mavxg/kitchen/Assemblies/GasMeterBoxing.FCStd

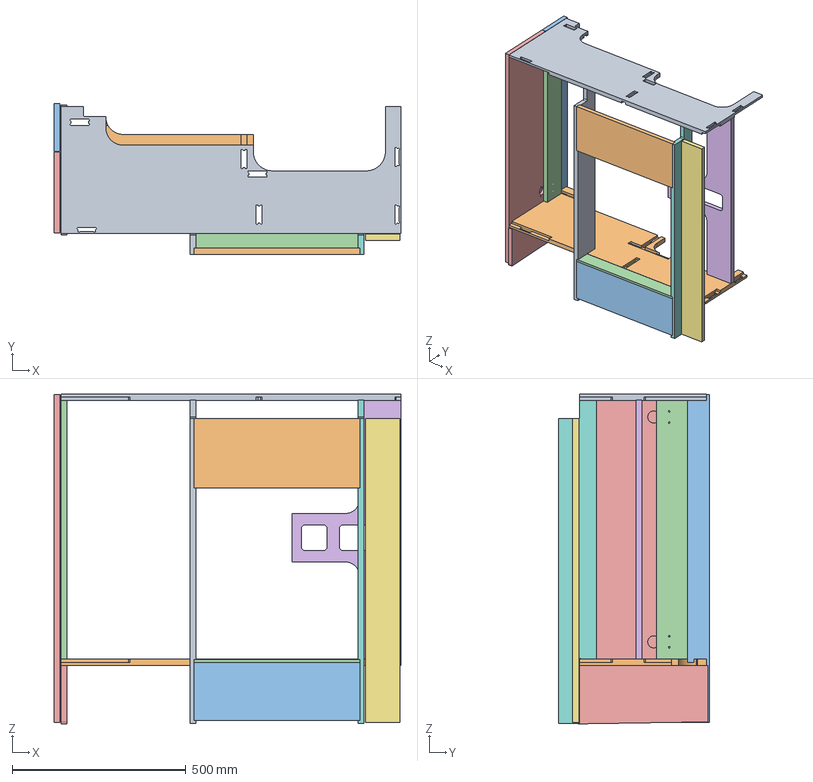
[picture p1: CAD file, 2022-05-16]
Assemblies/GasMeterBoxing.FCStd
1000.0 x 435.0 x 950.5 mm
Top012
Bottom014
Scriber
HingeUpright
Door
SocketMountUpright
Front
WorktopSupportUpright
WorktopSupportUpright002
TopSupportStretcher
BottomSupportStretcher
BottomSupportCross
Kickplate
