mavxg/kitchen/Assemblies/Cabinet011.FCStd

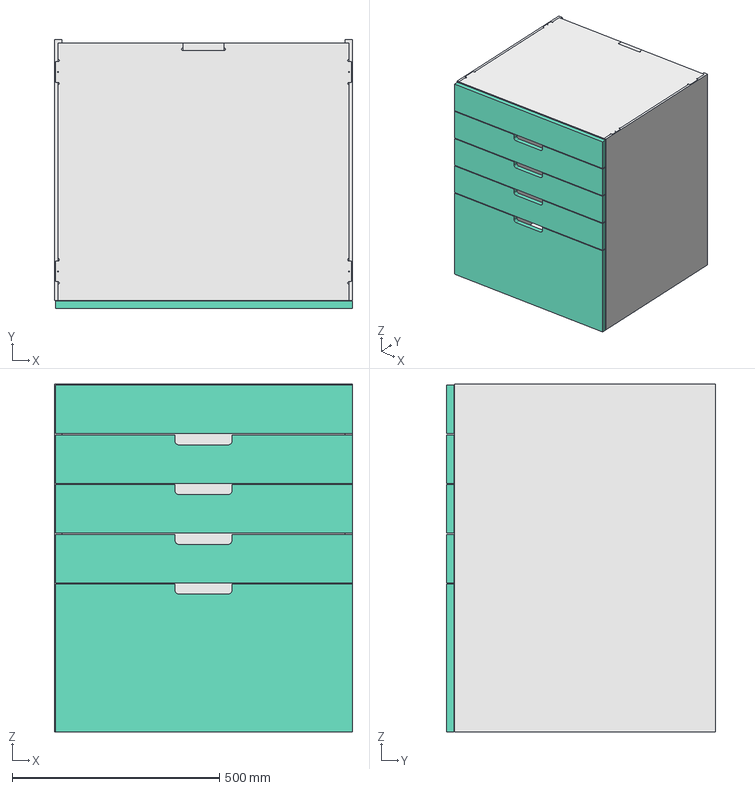
[picture p2: CAD file, 2022-05-16]
Assemblies/Cabinet011.FCStd
720.0 x 650.0 x 840.0 mm
Top
Bottom
Left
Right
BackPanel
Front001
Front002 x 3
Front005
