mavxg/kitchen/Components/QuookerPro3.FCStd

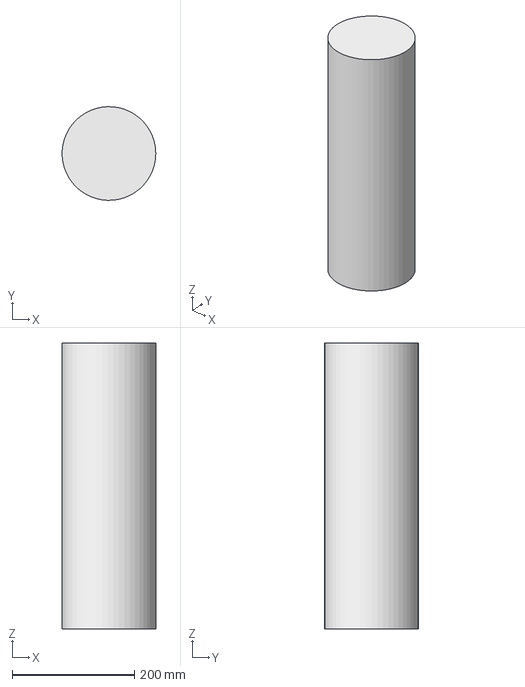
[picture p3: CAD file, 2022-05-16]
Components/QuookerPro3.FCStd
152.9 x 152.9 x 467.0 mm
