mavxg/kitchen/Kitchen.FCStd

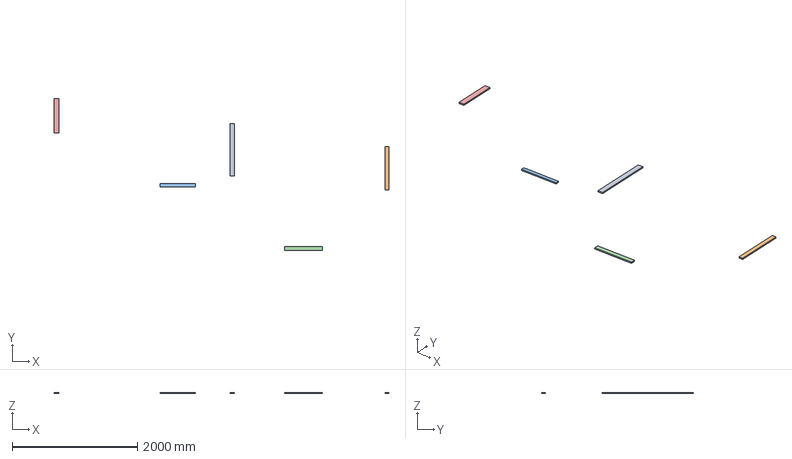
[picture p4: CAD file, 2022-05-16]
Kitchen.FCStd
5344.0 x 2419.0 x 18.0 mm
BattonForDrawerUnit
BattonForDrawerUnit001
BlackOutBatton
KickplateBathroom
CU_Batton
