mavxg/kitchen/Assemblies/Leveling.FCStd

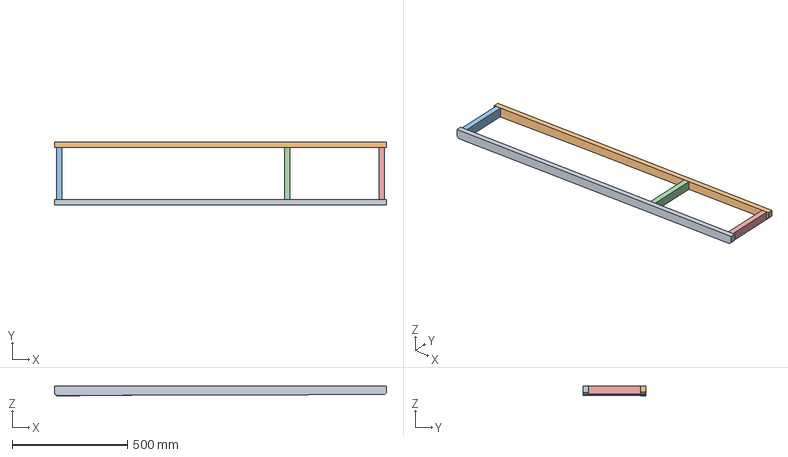
[picture p5: CAD file, 2022-05-16]
Assemblies/Leveling.FCStd
1438.0 x 274.0 x 42.9 mm
Front
Back
Stretcher
Stretcher001
Stretcher002
