mavxg/kitchen/Components/Radiator1.FCStd

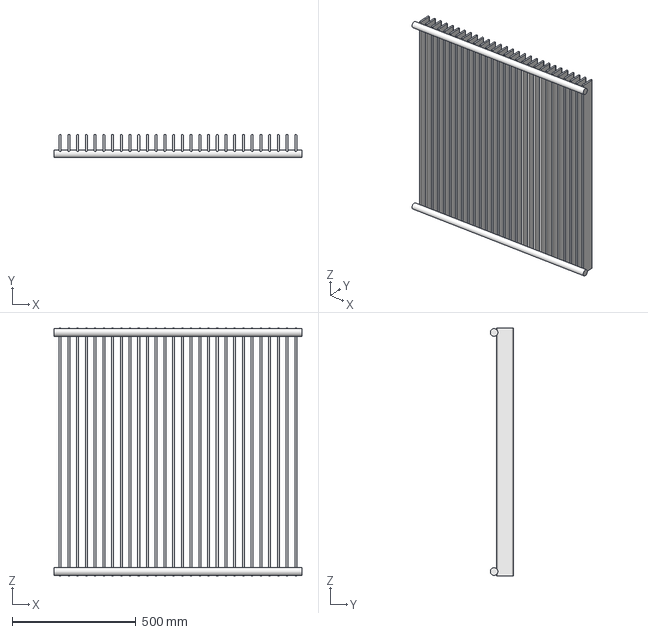
[picture p6: CAD file, 2022-05-16]
Components/Radiator1.FCStd
1000.0 x 94.7 x 1000.0 mm
