mavxg/kitchen/House.FCStd

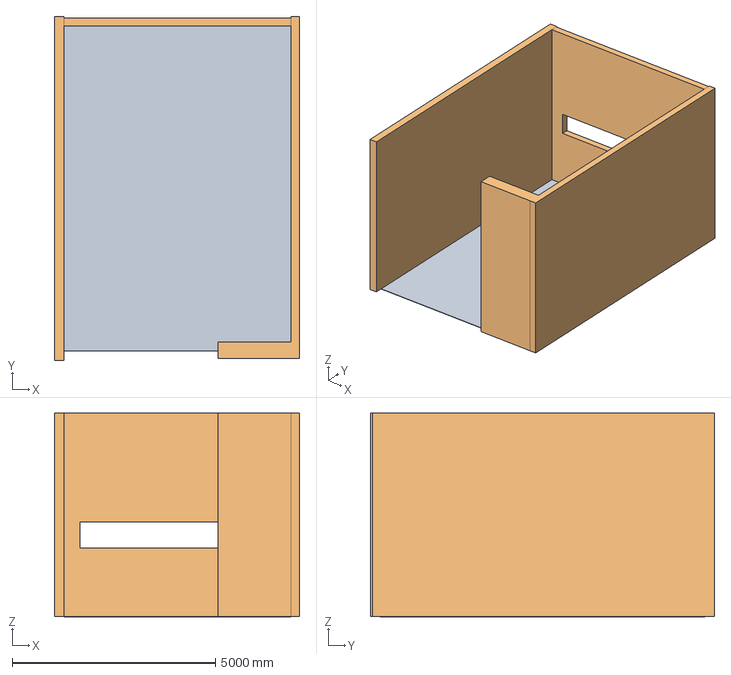
[picture p7: CAD file, 2022-05-16]
House.FCStd
6027.0 x 8464.5 x 5010.0 mm
Floor
Walls
