mavxg/kitchen/Assemblies/Cabinet012.FCStd

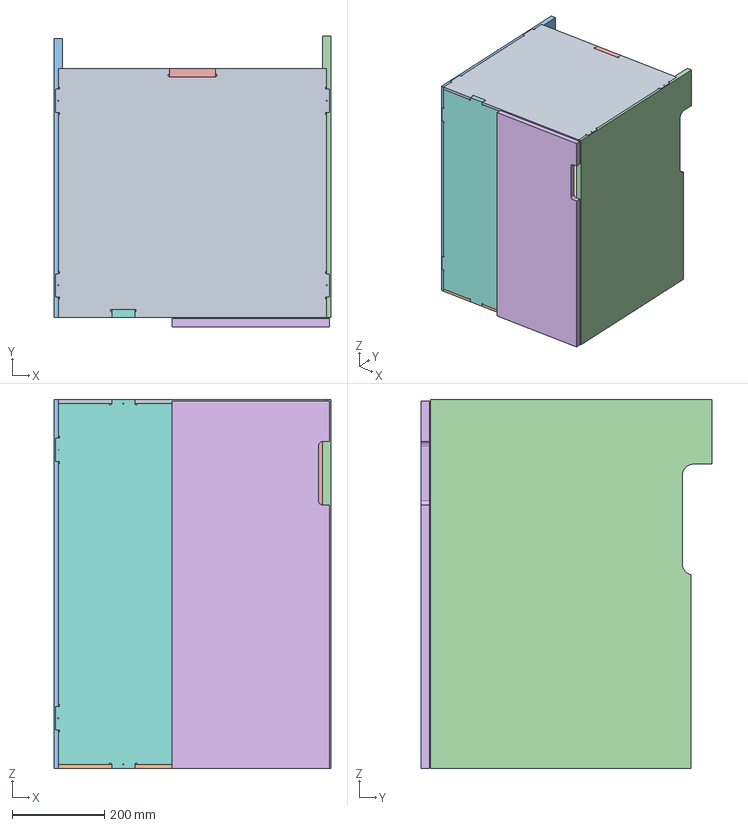
[picture p8: CAD file, 2022-05-16]
Assemblies/Cabinet012.FCStd
600.0 x 630.0 x 800.0 mm
Top
Bottom
Left
Right
BackPanel
LeftDoor
Shelf
FrontPanel
