mavxg/kitchen/Components/FrankeMythos210-45.FCStd

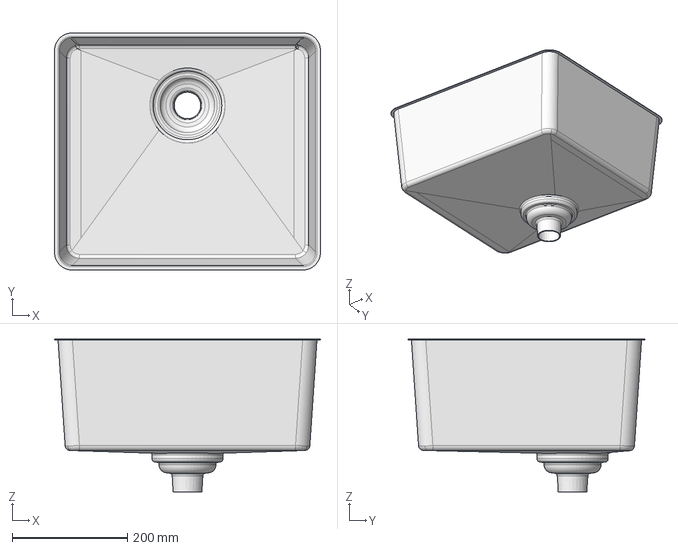
[picture p9: CAD file, 2022-05-16]
Components/FrankeMythos210-45.FCStd
462.0 x 412.0 x 265.0 mm
