mavxg/kitchen/Assemblies/Cabinet007.FCStd

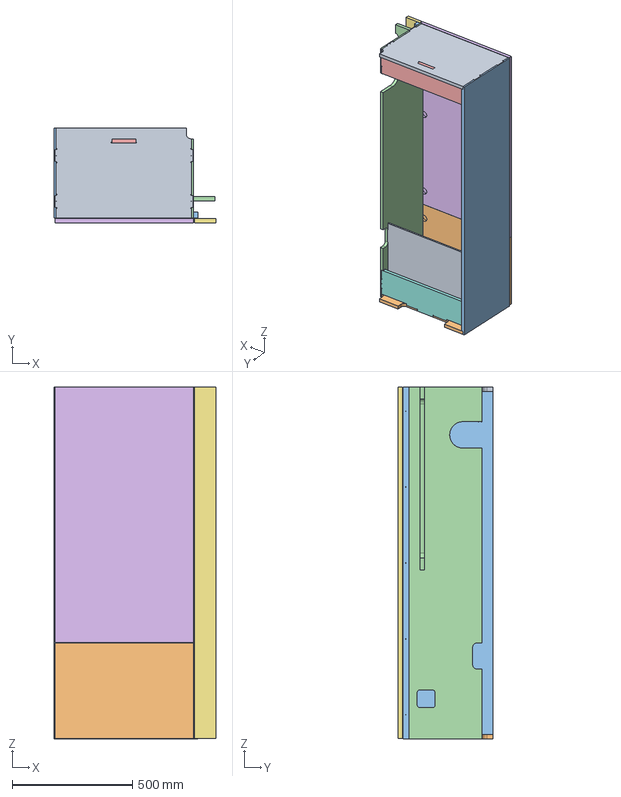
[picture p10: CAD file, 2022-05-16]
Assemblies/Cabinet007.FCStd
673.0 x 395.0 x 1463.0 mm
Top
Bottom
Left
Right
BackPanel
RightDoor
Scriber
BackPanel001
Back
RightDoor001
Batton
Bracing
