mavxg/kitchen/Components/Dline90Crank.FCStd

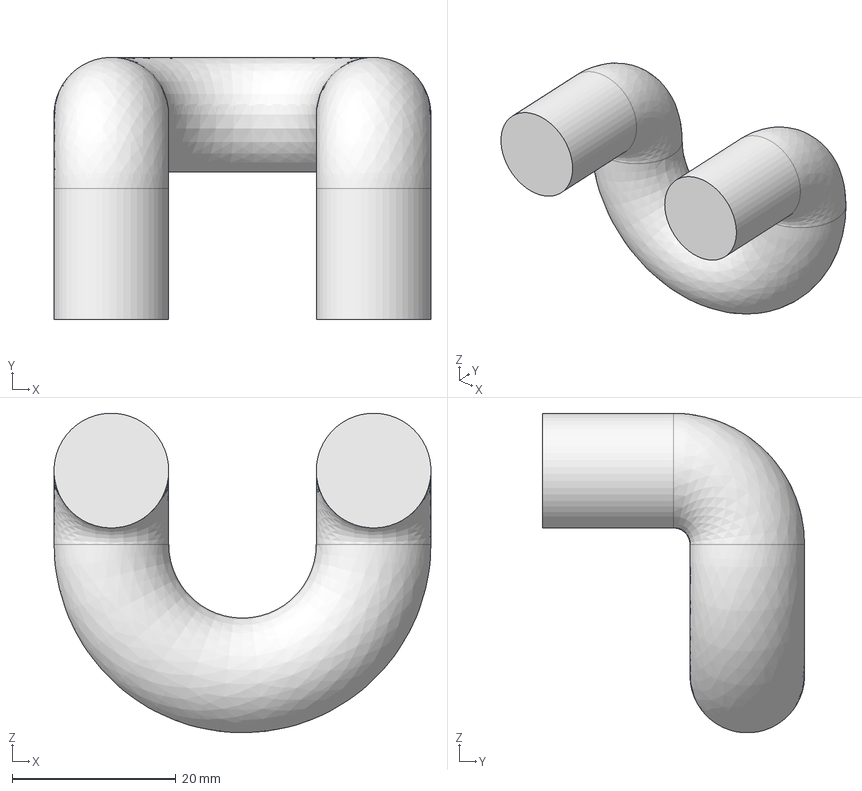
[picture p11: CAD file, 2022-05-16]
Components/Dline90Crank.FCStd
46.0 x 32.0 x 39.0 mm
