mavxg/kitchen/Assemblies/DrawerBox003.FCStd

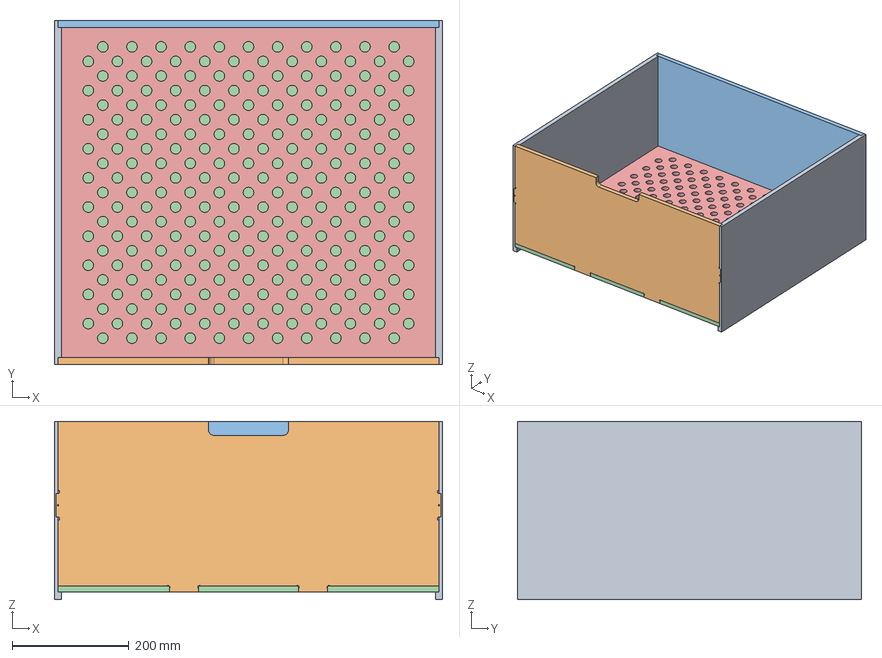
[picture p12: CAD file, 2022-05-16]
Assemblies/DrawerBox003.FCStd
666.0 x 590.0 x 306.0 mm
Left x 2
Front
Rear
Bottom
Inlay
