mavxg/kitchen/Components/Radiator2.FCStd

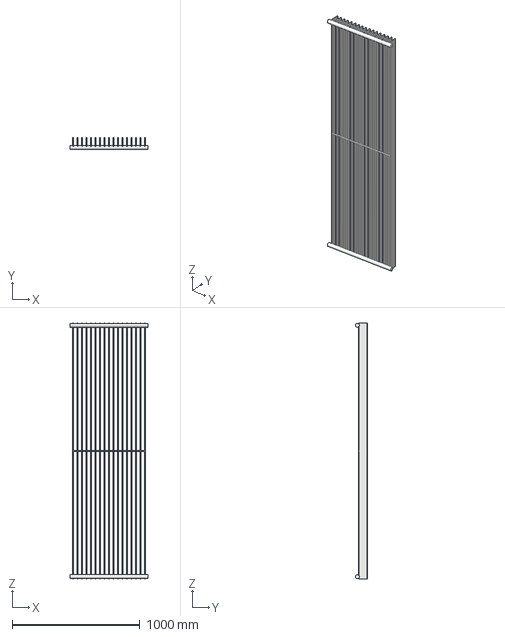
[picture p13: CAD file, 2022-05-16]
Components/Radiator2.FCStd
610.0 x 94.7 x 2000.0 mm
