mavxg/kitchen/Assemblies/DrawerBox002.FCStd

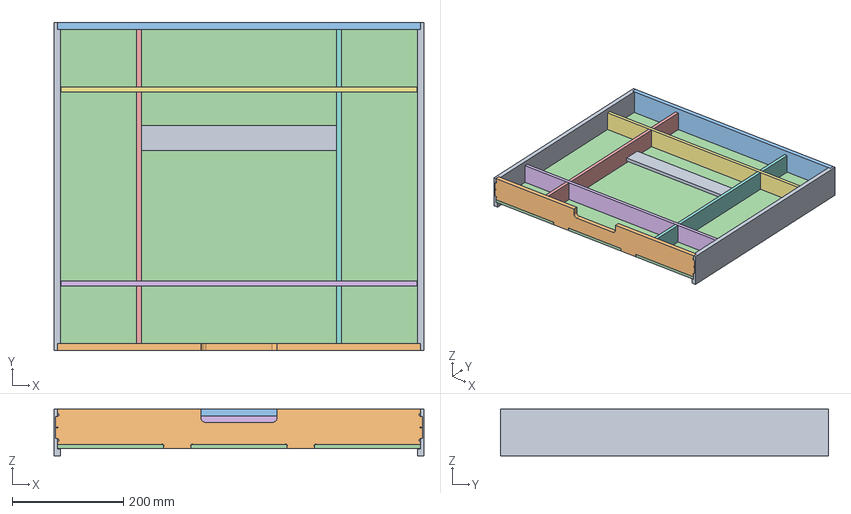
[picture p14: CAD file, 2022-05-16]
Assemblies/DrawerBox002.FCStd
666.0 x 590.0 x 84.0 mm
Left x 2
Front
Rear
Bottom
LongCrossDivider x 2
Divider001 x 2
Divider x 2
LongCrossDivider002 x 2
KnifeMagnetBlock x 2
