mavxg/kitchen/Components/BlancoOrga60_2.FCStd

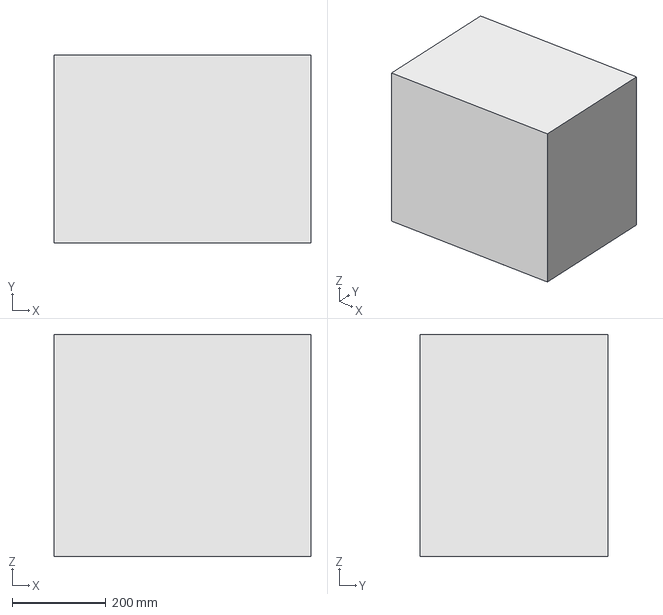
[picture p15: CAD file, 2022-05-16]
Components/BlancoOrga60_2.FCStd
547.0 x 400.0 x 473.0 mm
