mavxg/kitchen/Assemblies/IslandLeveling.FCStd

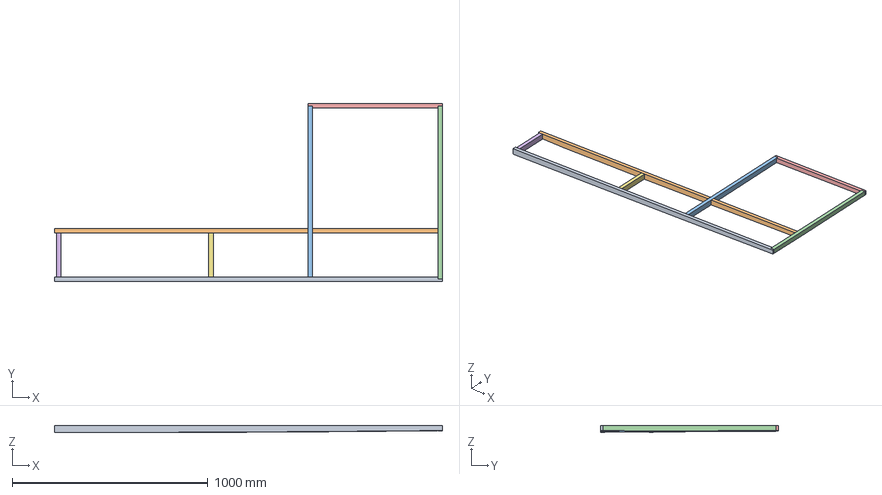
[picture p16: CAD file, 2022-05-16]
Assemblies/IslandLeveling.FCStd
1984.0 x 910.0 x 38.0 mm
Longways
Longways001
Crossways
Crossways001
Longways002
Stretcher
Stretcher001
