mavxg/kitchen/Components/QuookerFusionRound.FCStd

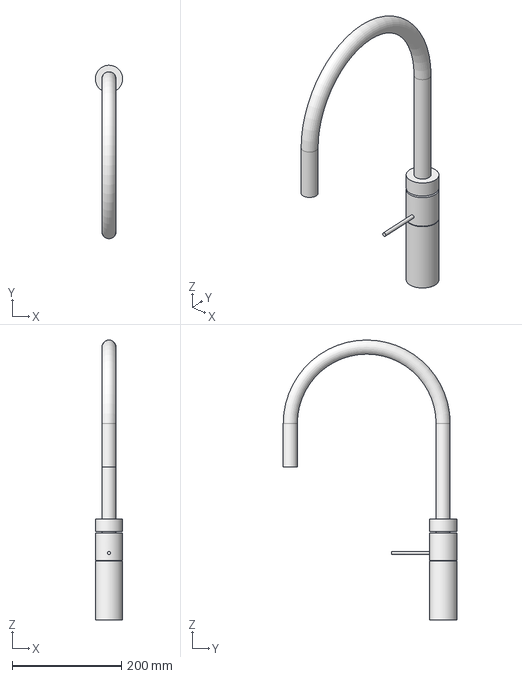
[picture p17: CAD file, 2022-05-16]
Components/QuookerFusionRound.FCStd
50.0 x 318.0 x 513.0 mm
