mavxg/kitchen/Assemblies/Cabinet009.FCStd

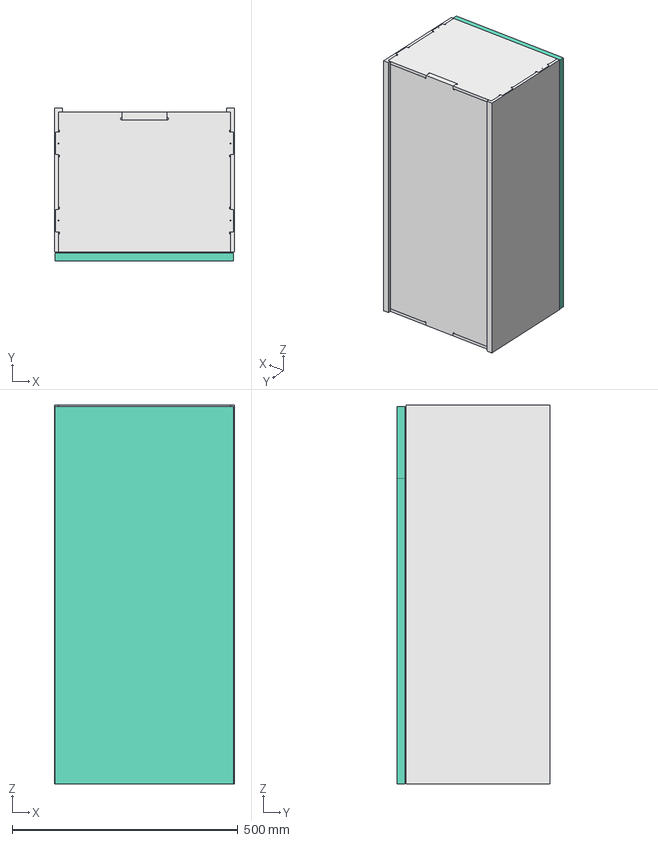
[picture p18: CAD file, 2022-05-16]
Assemblies/Cabinet009.FCStd
400.0 x 340.0 x 840.0 mm
Top
Bottom
Left
Right
BackPanel
LeftDoor
Shelf
