mavxg/kitchen/Components/DlineHandle.FCStd

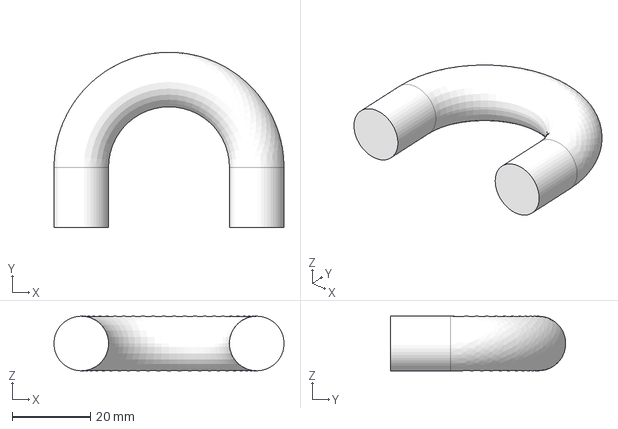
[picture p19: CAD file, 2022-05-01]
Components/DlineHandle.FCStd
59.0 x 45.0 x 14.0 mm
