mavxg/kitchen/Assemblies/Footing.FCStd

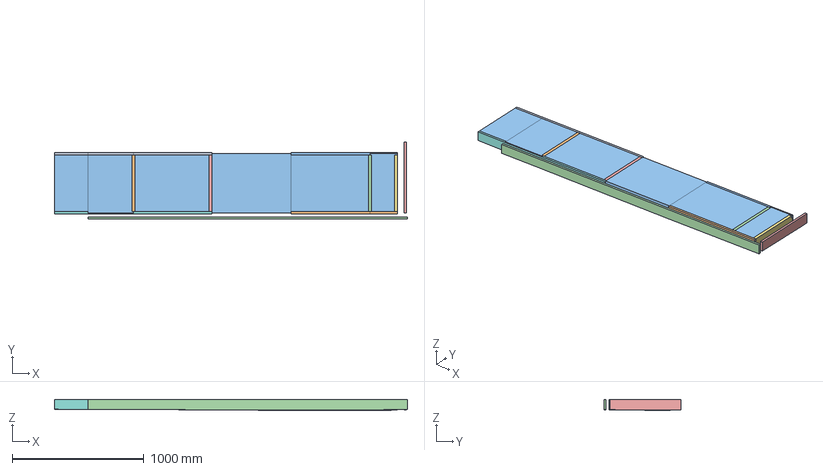
[picture p20: CAD file, 2022-05-16]
Assemblies/Footing.FCStd
2683.0 x 588.0 x 81.9 mm
Cross
Cross001
Skeleton
Cross004
Cross002
Cross003
Cross005
LeftFront
LeftRear
RightFront
RightRear
Kickplate
EndKickplate
