mavxg/kitchen/Components/Blum.FCStd

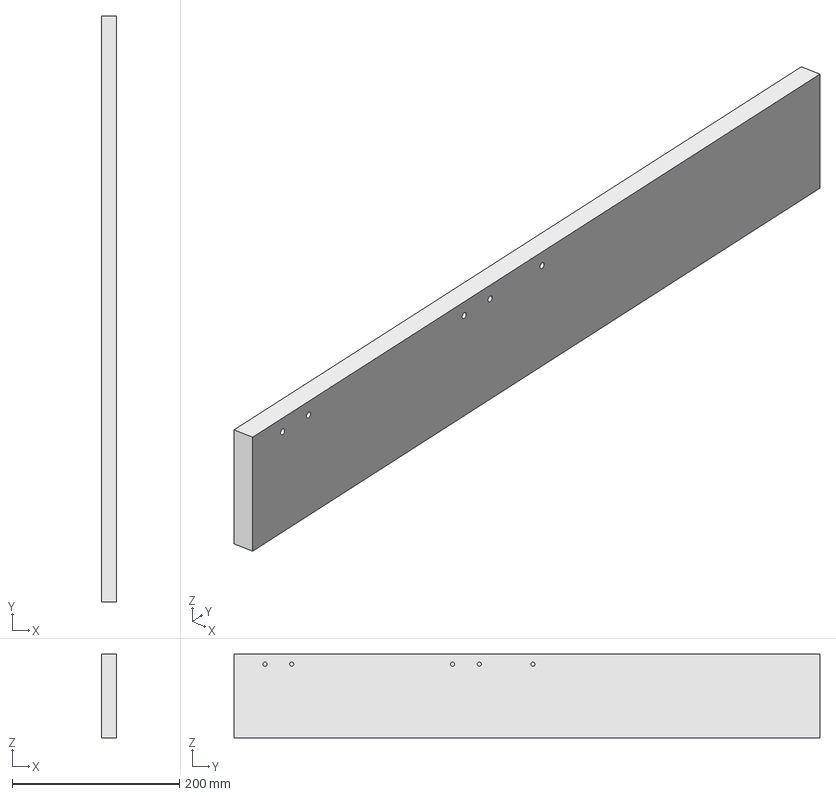
[picture p21: CAD file, 2022-05-01]
Components/Blum.FCStd
18.0 x 700.0 x 100.0 mm
