mavxg/kitchen/Assemblies/Cabinet001.FCStd

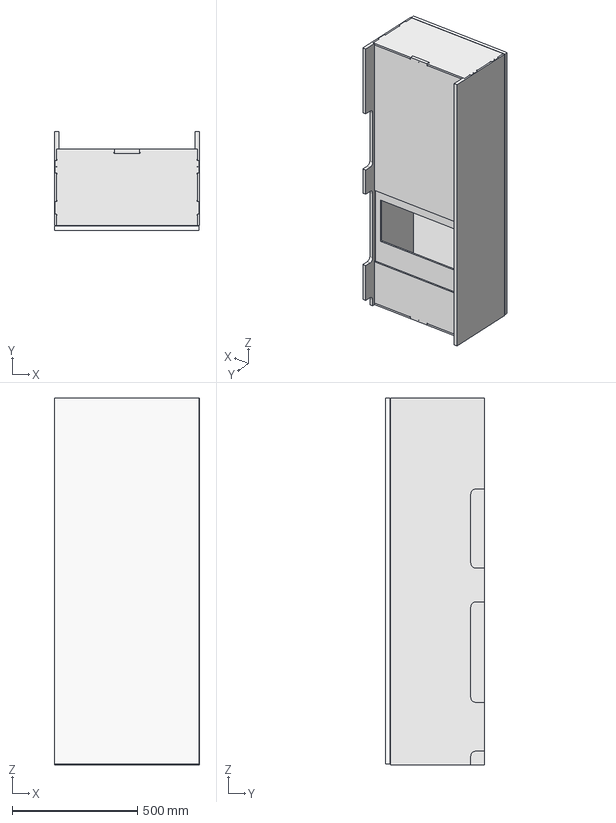
[picture p22: CAD file, 2022-05-16]
Assemblies/Cabinet001.FCStd
580.0 x 395.0 x 1463.0 mm
Top
Bottom
Left
Right
BackPanelBottom
RightDoor
Shelf
BackPanelTop
RemovableBack
