mavxg/kitchen/Components/Radiator3.FCStd

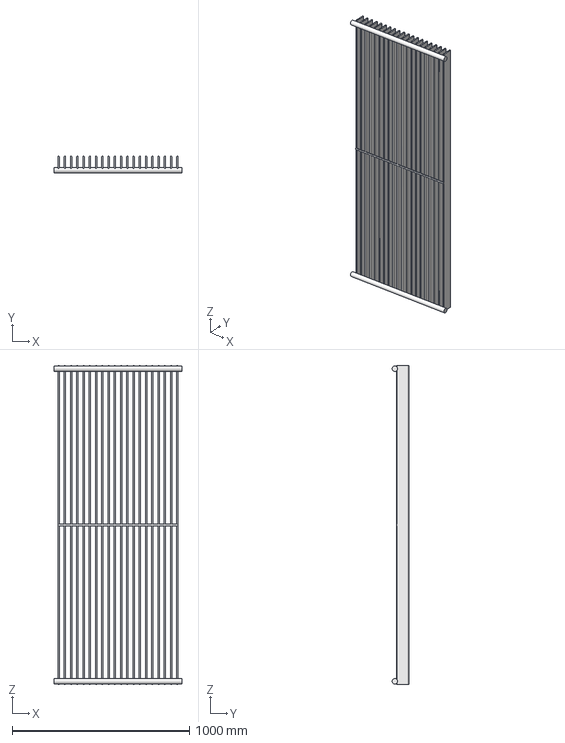
[picture p23: CAD file, 2022-05-01]
Components/Radiator3.FCStd
720.0 x 94.7 x 1800.0 mm
