mavxg/kitchen/Assemblies/Cabinet015.FCStd

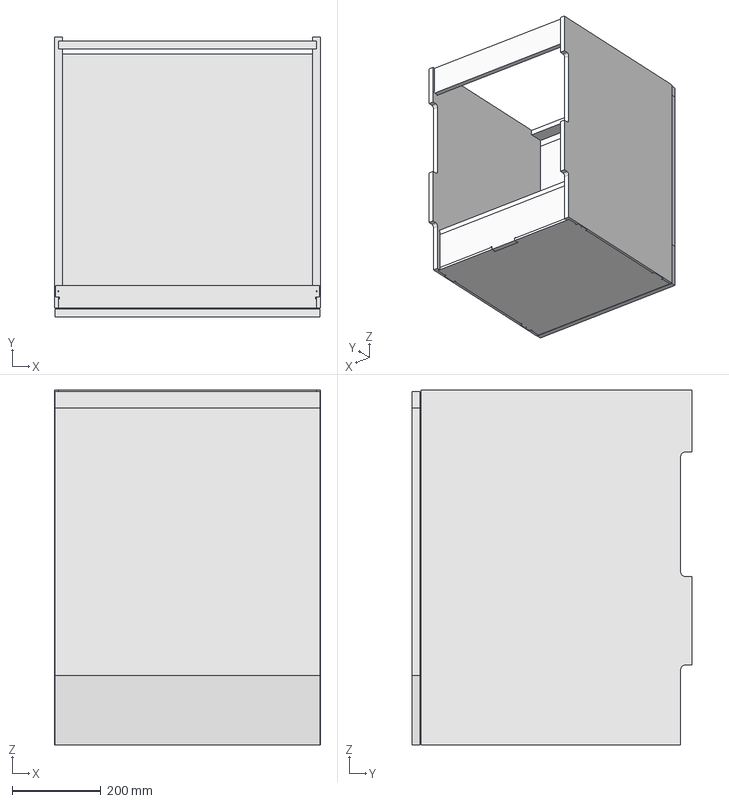
[picture p24: CAD file, 2022-05-16]
Assemblies/Cabinet015.FCStd
600.0 x 630.0 x 800.0 mm
TopStretcher
Bottom
Left
Right
BackPanel
LeftDoor
Shelf
FrontPanel001
FrontPanel002
BackStretcher002
