mavxg/kitchen/Components/PullHandle.FCStd

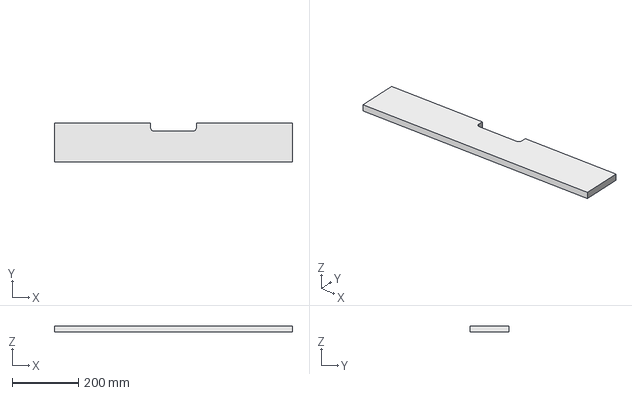
[picture p25: CAD file, 2022-04-24]
Components/PullHandle.FCStd
717.0 x 117.0 x 18.0 mm
