mavxg/kitchen/Assemblies/DrawerBoxEnd003.FCStd

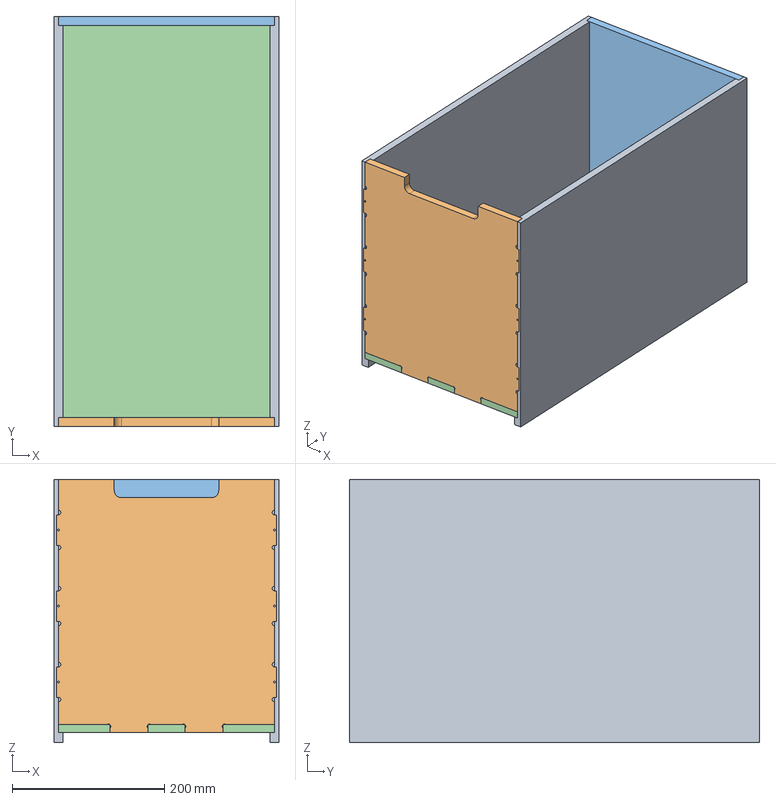
[picture p26: CAD file, 2022-05-16]
Assemblies/DrawerBoxEnd003.FCStd
296.0 x 540.0 x 346.0 mm
Left x 2
Front
Rear
Bottom
