mavxg/kitchen/Components/DrawerBox.FCStd

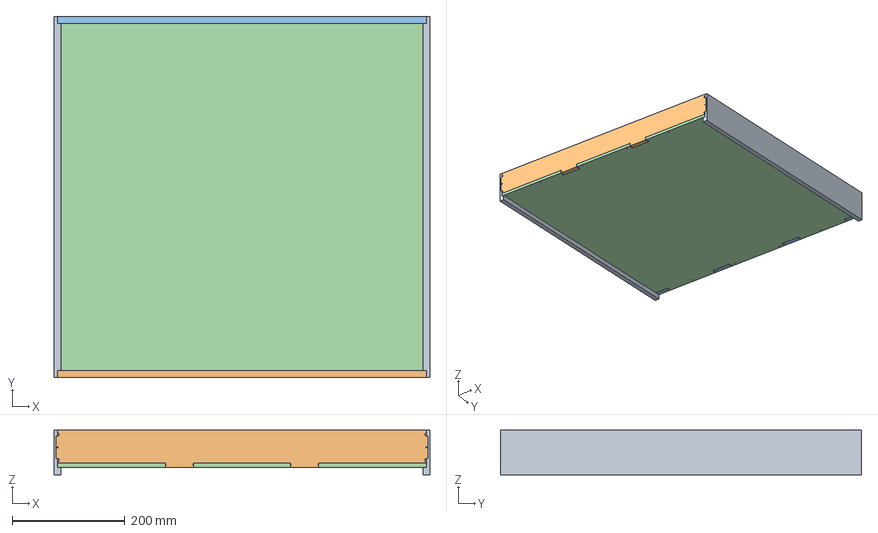
[picture p27: CAD file, 2022-04-24]
Components/DrawerBox.FCStd
666.0 x 640.0 x 79.0 mm
Left x 2
Front
Rear
Bottom
