mavxg/kitchen/Assemblies/Cabinet003.FCStd

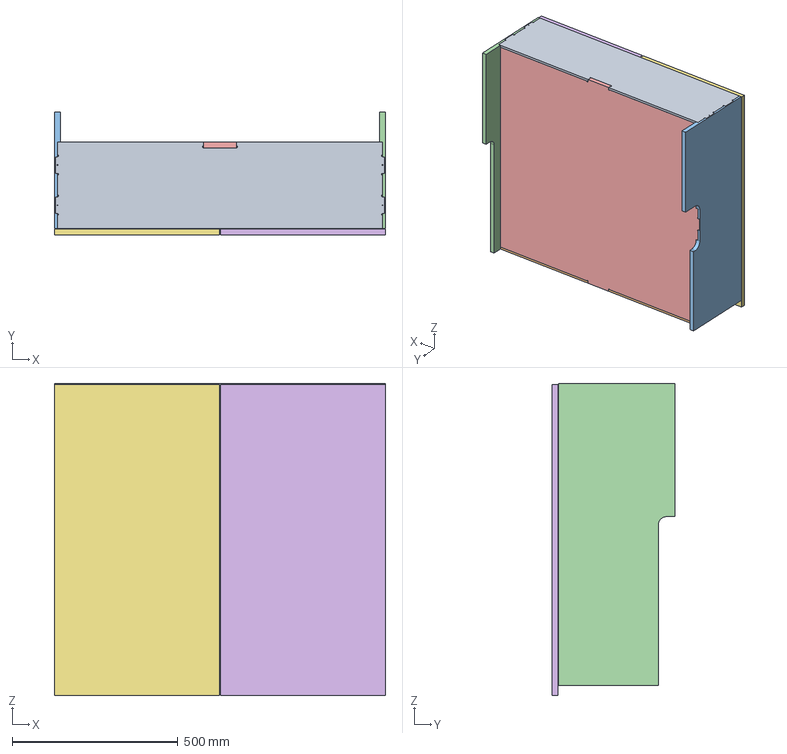
[picture p28: CAD file, 2022-05-16]
Assemblies/Cabinet003.FCStd
1000.0 x 371.0 x 944.0 mm
Top
Bottom
Left
Right
BackPanel
RightDoor
LeftDoor
Shelf
