mavxg/kitchen/Assemblies/IslandWorktop.FCStd

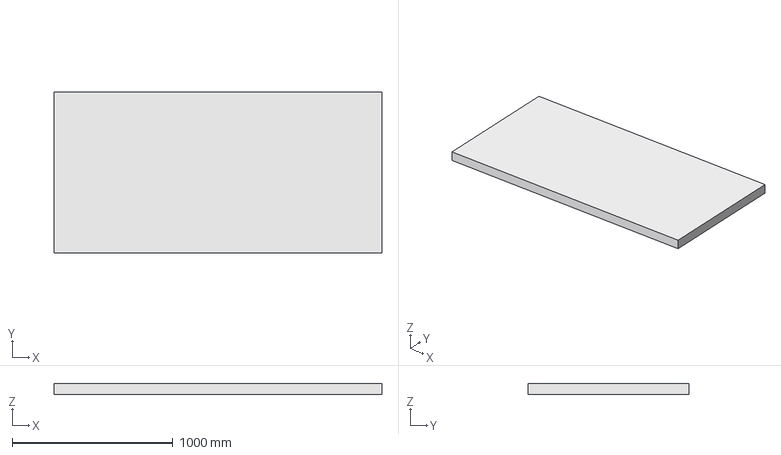
[picture p29: CAD file, 2022-05-16]
Assemblies/IslandWorktop.FCStd
2040.0 x 1004.0 x 70.0 mm
