mavxg/kitchen/Assemblies/WindowSill.FCStd

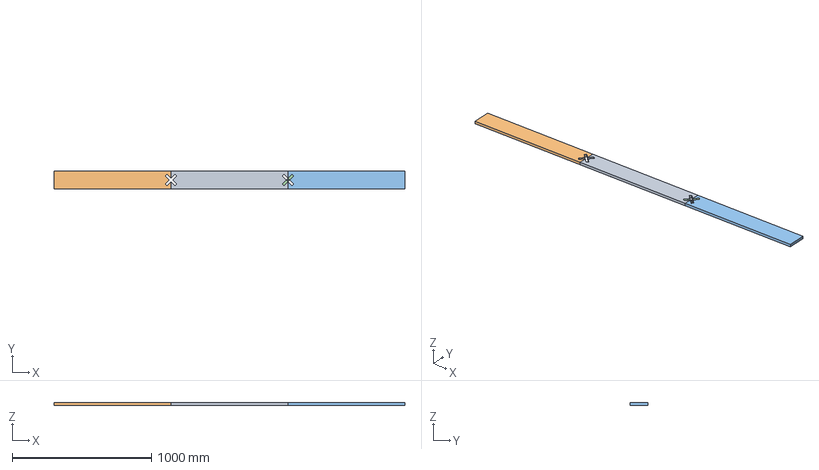
[picture p30: CAD file, 2022-05-16]
Assemblies/WindowSill.FCStd
2520.0 x 130.0 x 18.0 mm
Mid
Left
Right
Joint
