mavxg/kitchen/Assemblies/Cabinet005.FCStd

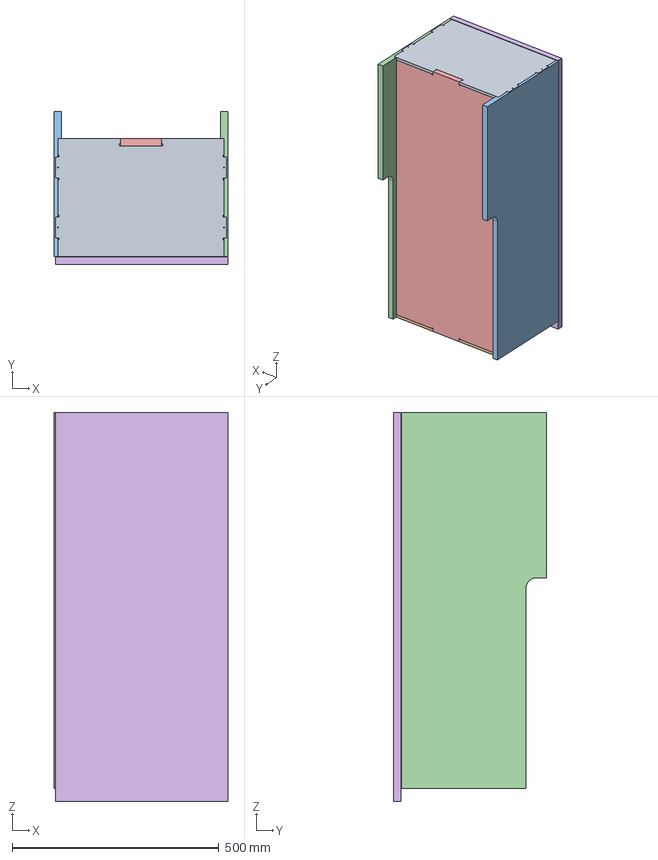
[picture p31: CAD file, 2022-05-16]
Assemblies/Cabinet005.FCStd
420.0 x 371.0 x 941.0 mm
Top
Bottom
Left
Right
BackPanel
RightDoor
Shelf
