mavxg/kitchen/Assemblies/UnderBoilerBoxing.FCStd

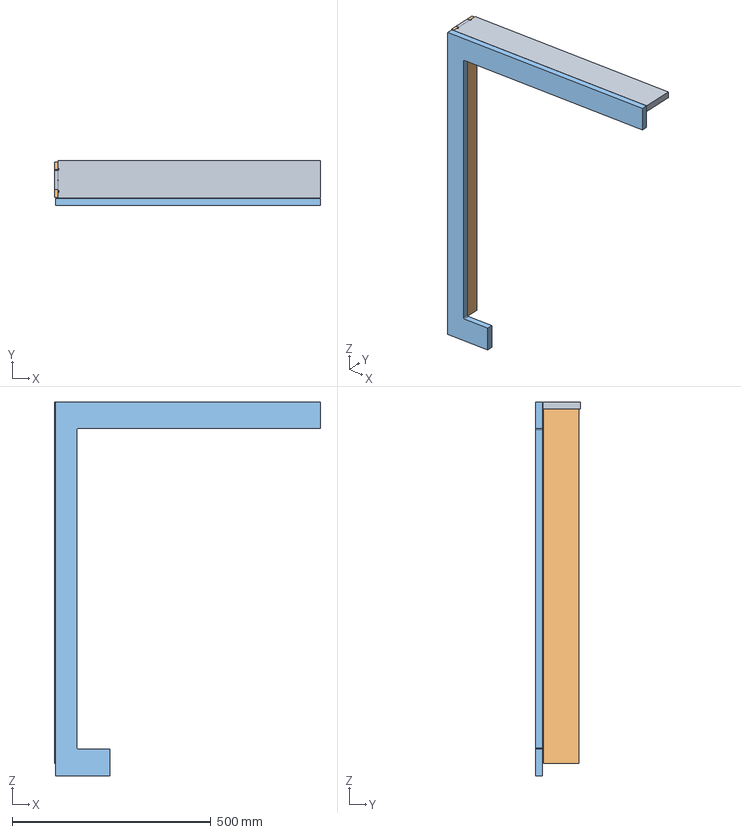
[picture p32: CAD file, 2022-05-16]
Assemblies/UnderBoilerBoxing.FCStd
670.0 x 113.2 x 941.0 mm
Top
Left
FrontPanel
