mavxg/kitchen/Assemblies/DrawerBoxOven.FCStd

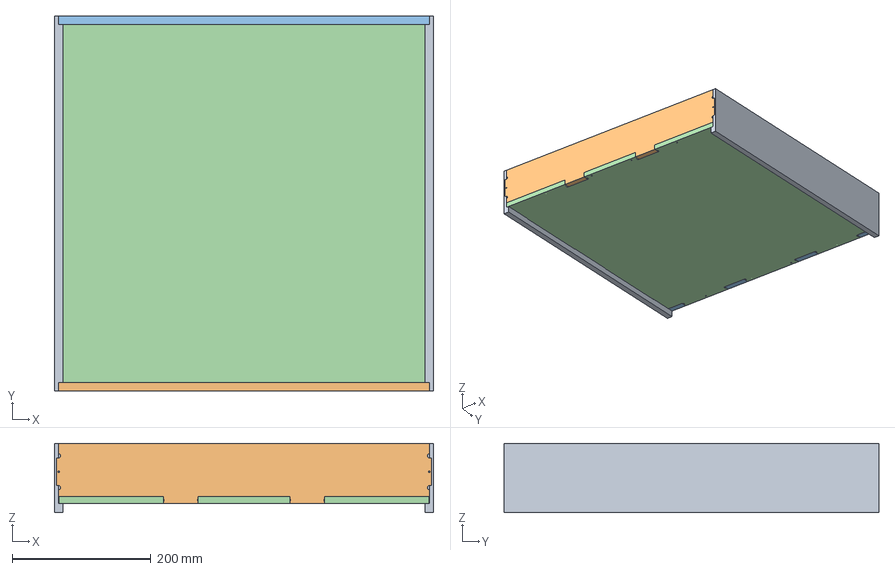
[picture p33: CAD file, 2022-05-16]
Assemblies/DrawerBoxOven.FCStd
546.0 x 540.0 x 100.0 mm
Left x 2
Front
Rear
Bottom
