mavxg/kitchen/Assemblies/DrawerBoxEnd002.FCStd

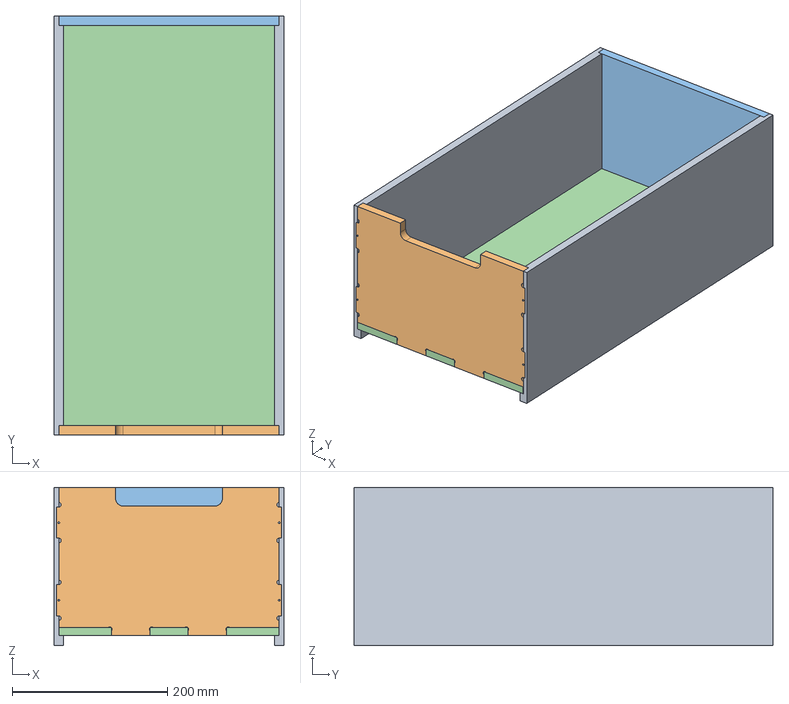
[picture p34: CAD file, 2022-05-16]
Assemblies/DrawerBoxEnd002.FCStd
296.0 x 540.0 x 204.0 mm
Left x 2
Front
Rear
Bottom
