mavxg/kitchen/Assemblies/RearWorktop.FCStd

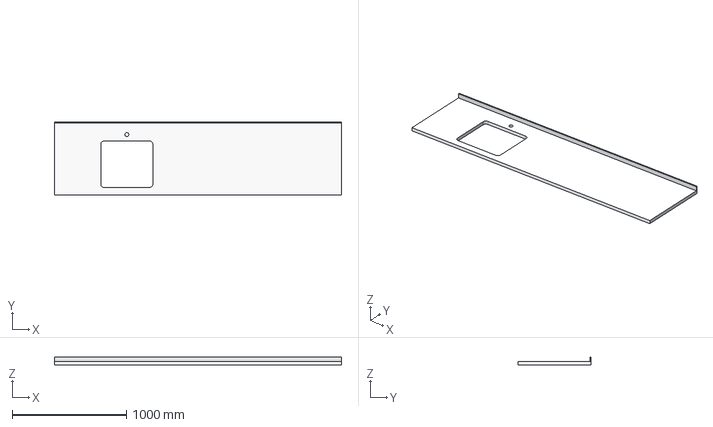
[picture p35: CAD file, 2022-05-16]
Assemblies/RearWorktop.FCStd
2516.0 x 640.0 x 70.0 mm
Upstand
RearWorktop
