mavxg/kitchen/Assemblies/Cabinet008.FCStd

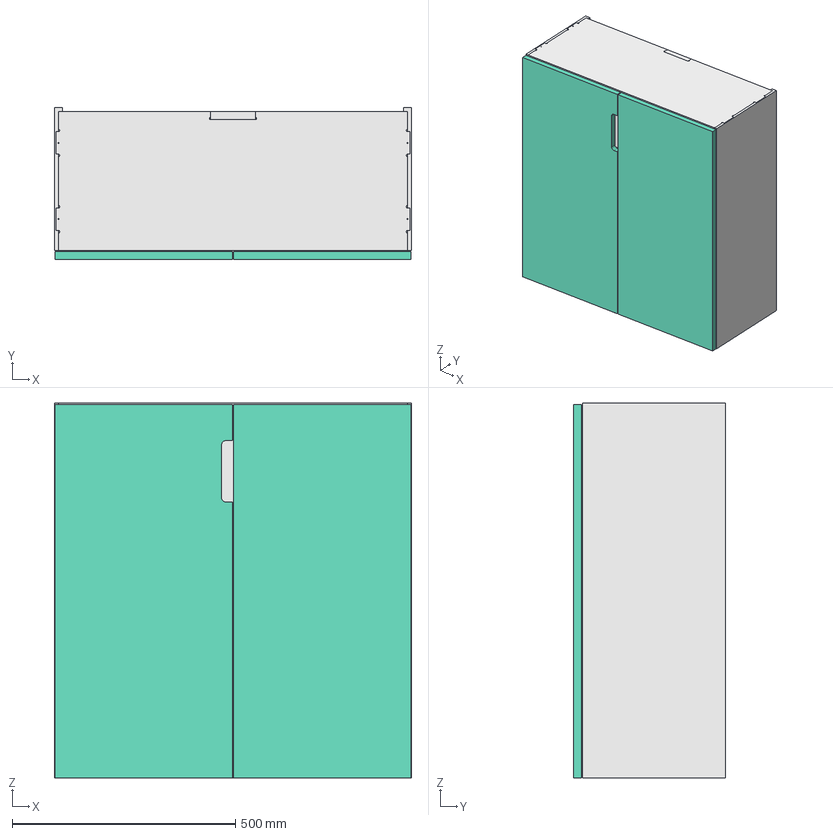
[picture p36: CAD file, 2022-05-16]
Assemblies/Cabinet008.FCStd
800.0 x 340.0 x 840.0 mm
Top
Bottom
Left
Right
BackPanel
RightDoor
LeftDoor
Shelf
