mavxg/kitchen/Assemblies/Cabinet016.FCStd

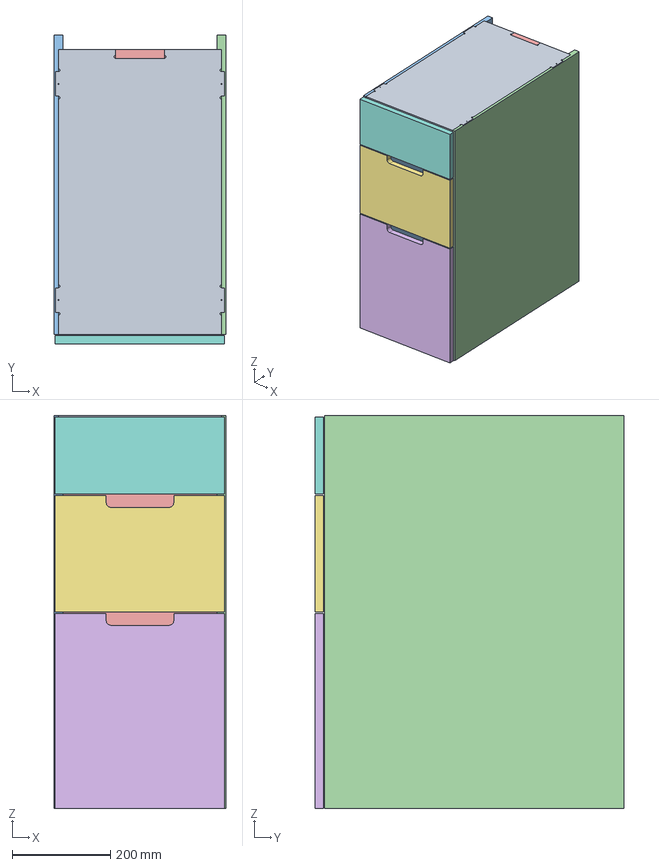
[picture p37: CAD file, 2022-05-16]
Assemblies/Cabinet016.FCStd
350.0 x 630.0 x 800.0 mm
Top
Bottom
Left
Right
BackPanel
Front001
Front002
Front003
