mavxg/kitchen/Assemblies/Battons.FCStd

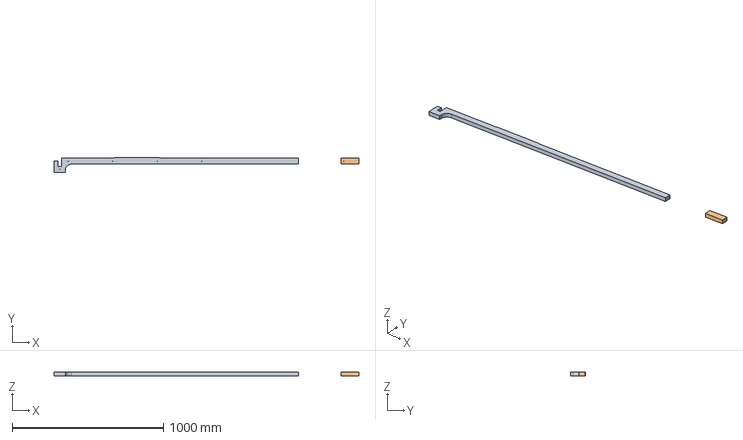
[picture p38: CAD file, 2022-05-16]
Assemblies/Battons.FCStd
2015.0 x 97.0 x 24.0 mm
Batton
Batton001
