mavxg/kitchen/Assemblies/Cabinet014.FCStd

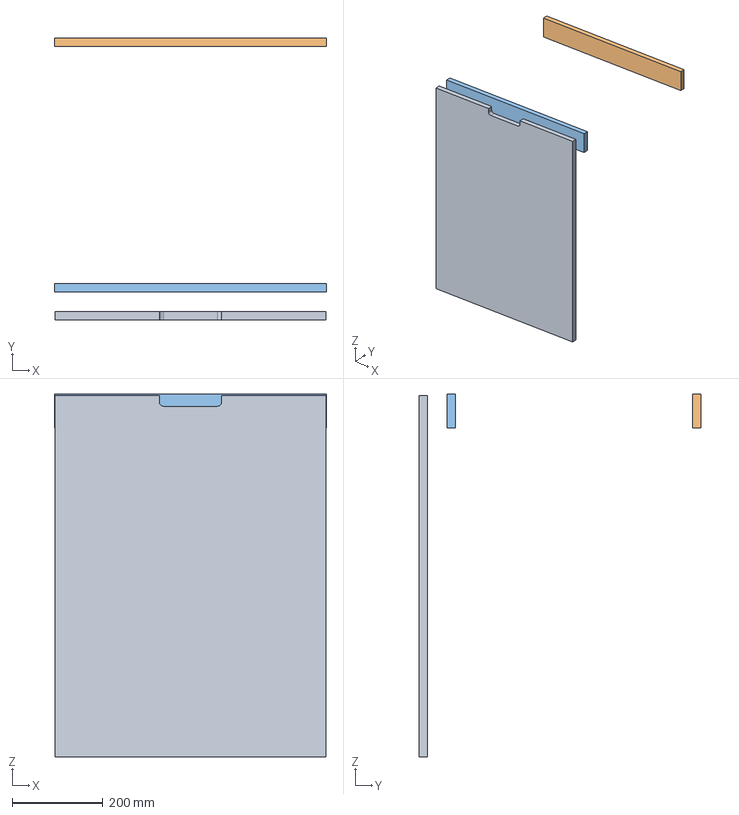
[picture p39: CAD file, 2022-05-16]
Assemblies/Cabinet014.FCStd
600.0 x 621.0 x 800.0 mm
FrontPanel
Stretcher
Stretcher001
