mavxg/kitchen/Assemblies/Cubby.FCStd

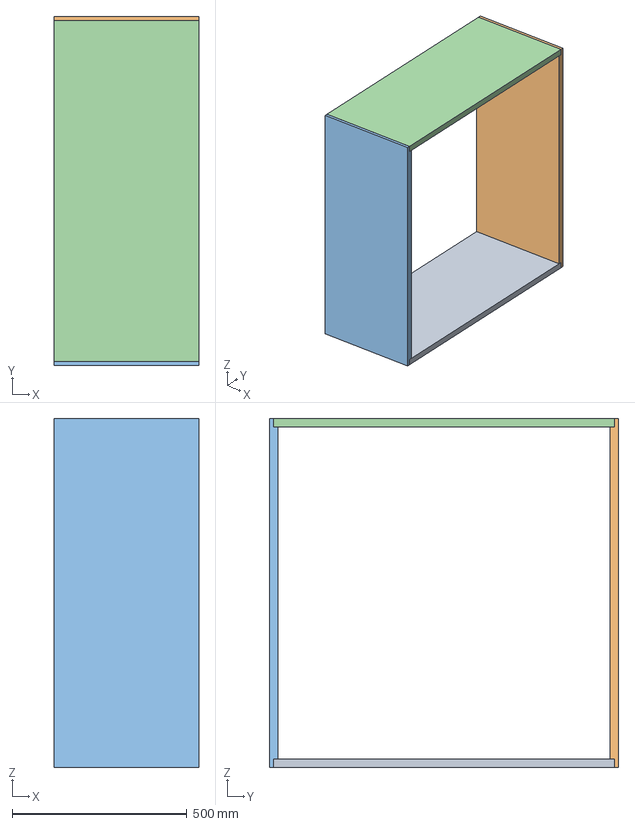
[picture p40: CAD file, 2022-05-16]
Assemblies/Cubby.FCStd
415.0 x 1000.0 x 1000.0 mm
Bottom
Right
Left
Top
