mavxg/kitchen/Assemblies/Cabinet006.FCStd

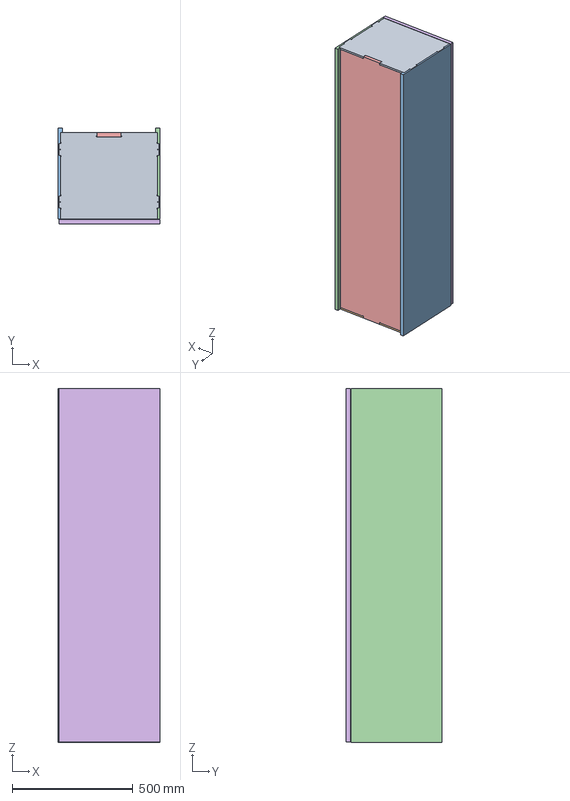
[picture p41: CAD file, 2022-05-16]
Assemblies/Cabinet006.FCStd
420.0 x 395.0 x 1463.0 mm
Top
Bottom
Left
Right
BackPanel
RightDoor
Shelf
