mavxg/kitchen/Assemblies/Fridge.FCStd

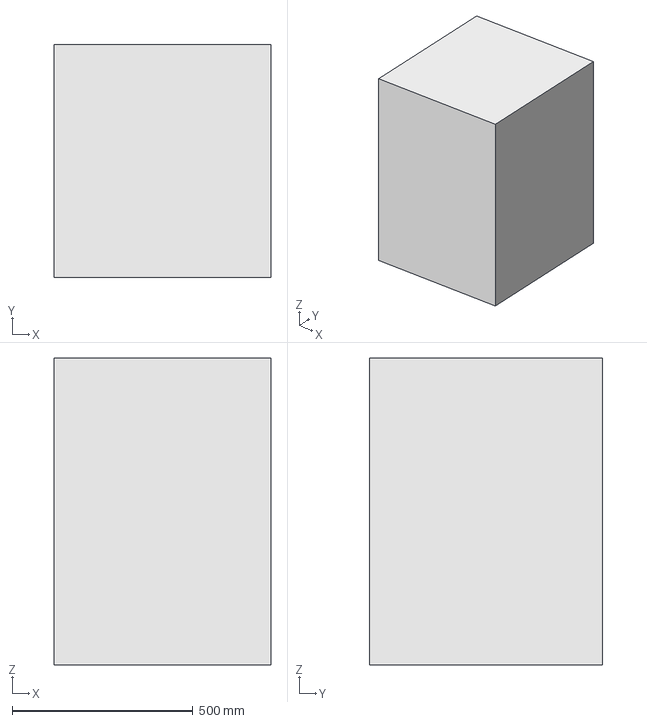
[picture p42: CAD file, 2022-05-16]
Assemblies/Fridge.FCStd
600.0 x 645.0 x 850.0 mm
