mavxg/kitchen/Assemblies/Cabinet002.FCStd

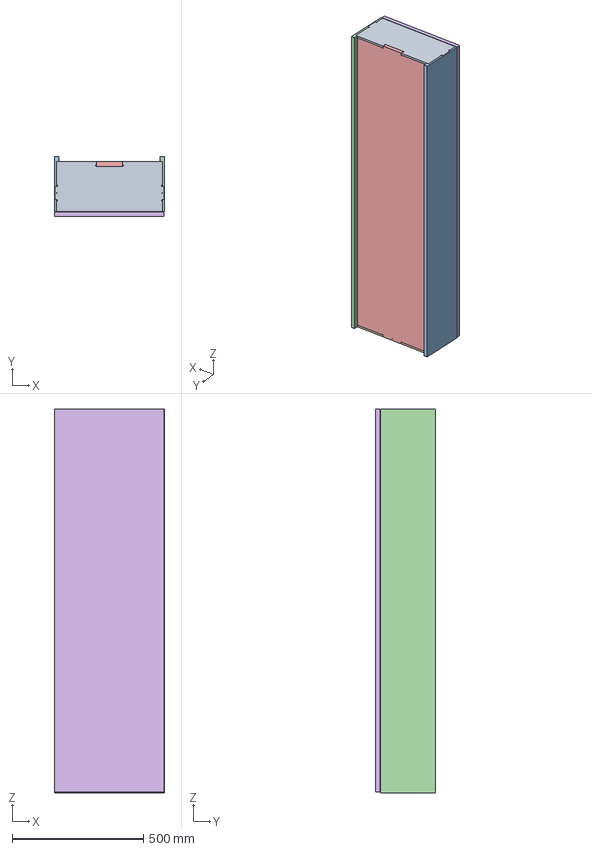
[picture p43: CAD file, 2022-05-16]
Assemblies/Cabinet002.FCStd
420.0 x 230.0 x 1463.0 mm
Top
Bottom
Left
Right
BackPanel
LeftDoor
Shelf
