mavxg/kitchen/Assemblies/RearEndPanel.FCStd

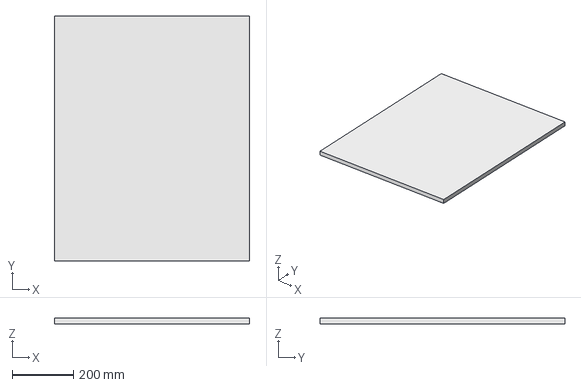
[picture p44: CAD file, 2022-05-16]
Assemblies/RearEndPanel.FCStd
635.0 x 797.0 x 18.0 mm
