mavxg/kitchen/Assemblies/Cabinet004.FCStd

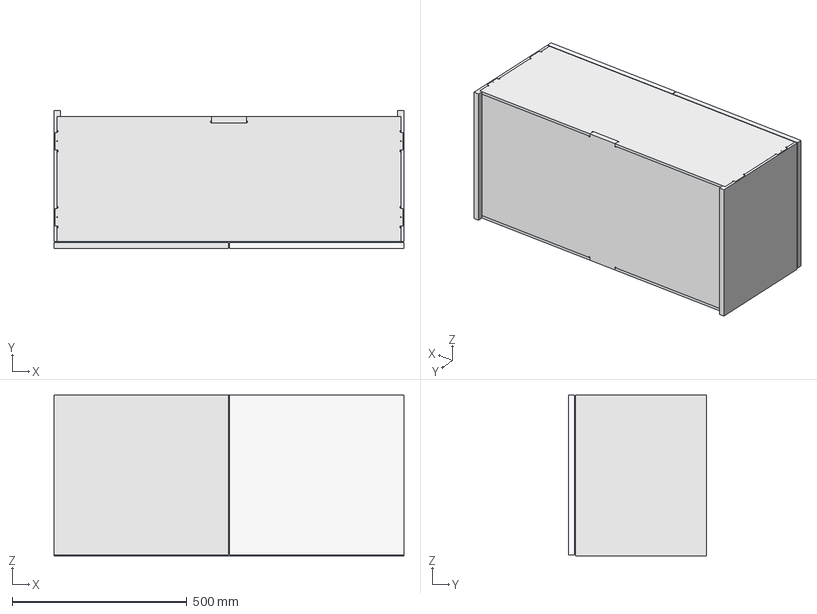
[picture p45: CAD file, 2022-05-16]
Assemblies/Cabinet004.FCStd
1000.0 x 395.0 x 460.0 mm
Top
Bottom
Left
Right
BackPanel
RightDoor
LeftDoor
Shelf
