mavxg/kitchen/Assemblies/DrawerBox001.FCStd

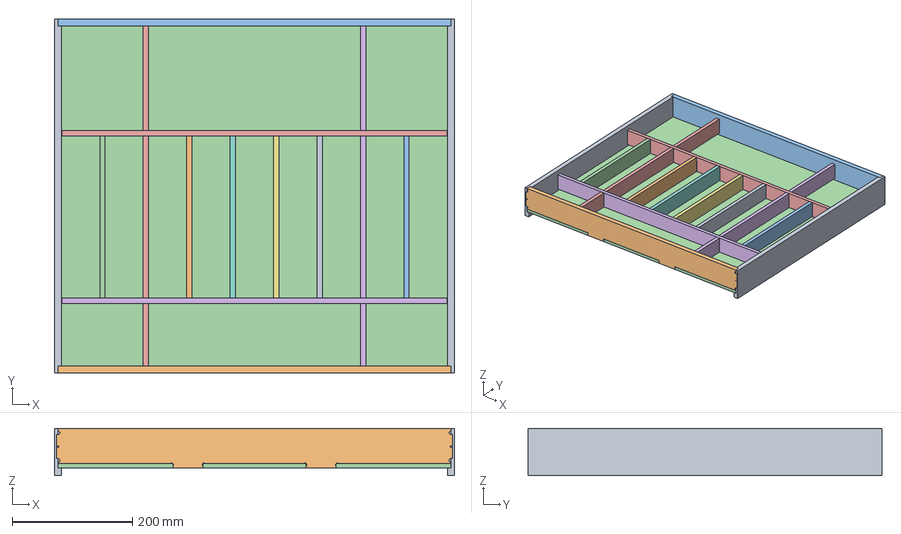
[picture p46: CAD file, 2022-05-16]
Assemblies/DrawerBox001.FCStd
666.0 x 590.0 x 79.0 mm
Left x 2
Front
Rear
Bottom
Divider
Divider001
CrossDivider
CrossDivider001
CrossDivider002
CrossDivider003
CrossDivider004
CrossDivider005
LongCrossDivider
LongCrossDivider001
