mavxg/kitchen/Assemblies/Cabinet013.FCStd

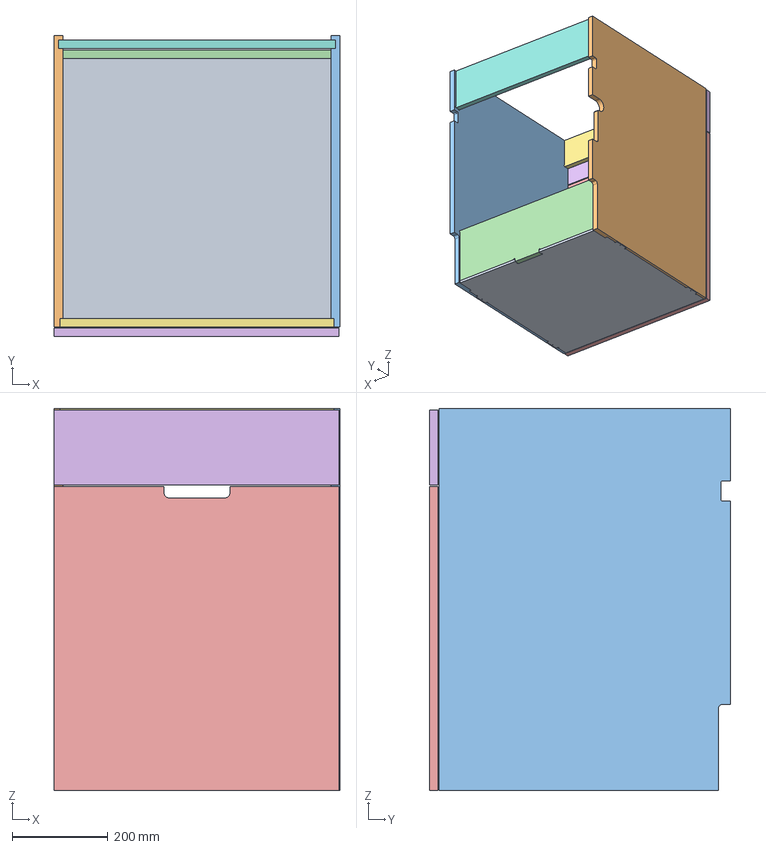
[picture p47: CAD file, 2022-05-16]
Assemblies/Cabinet013.FCStd
598.0 x 630.0 x 800.0 mm
Bottom
Left
Right
BackPanel
Front001
Front002
FrontStretcher
BackStretcher
