mavxg/kitchen/Assemblies/DrawerBoxEnd001.FCStd

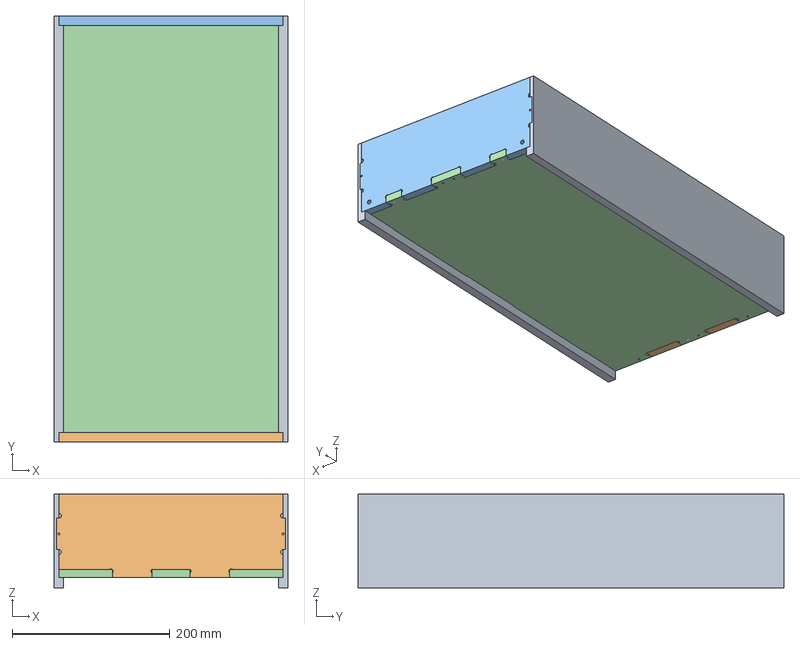
[picture p48: CAD file, 2022-05-16]
Assemblies/DrawerBoxEnd001.FCStd
296.0 x 540.0 x 119.0 mm
Left x 2
Front
Rear
Bottom
