mavxg/kitchen/Assemblies/IslandEndPanel.FCStd

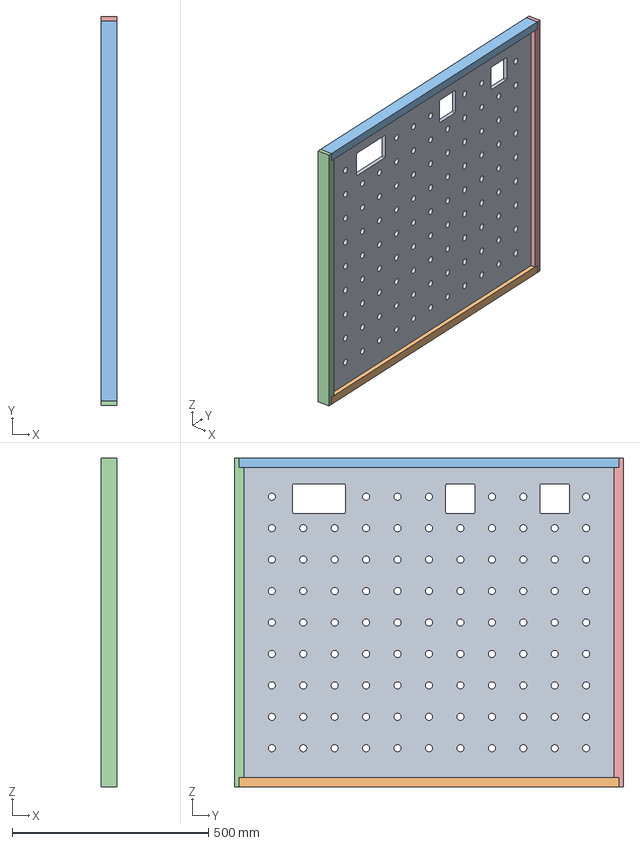
[picture p49: CAD file, 2022-04-23]
Assemblies/IslandEndPanel.FCStd
40.0 x 990.0 x 837.0 mm
PegBoard
Bottom
Top
Left
Right
