mavxg/kitchen/Assemblies/BasicCabinetWithDoorLeftHinge.FCStd

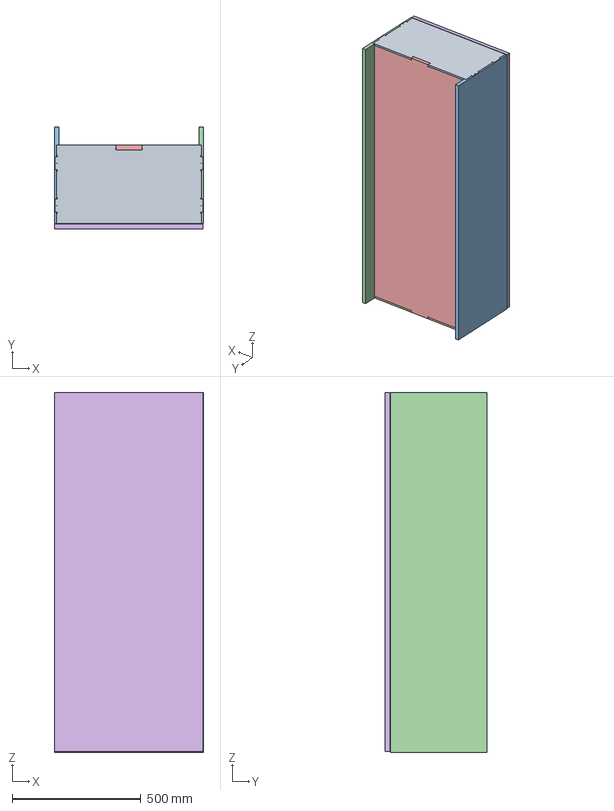
[picture p50: CAD file, 2022-04-19]
Assemblies/BasicCabinetWithDoorLeftHinge.FCStd
580.0 x 395.0 x 1400.0 mm
Top
Bottom
Left
Right
BackPanel
LeftDoor
Shelf
