mavxg/kitchen/Assemblies/BasicCabinetWithTwoDoors.FCStd

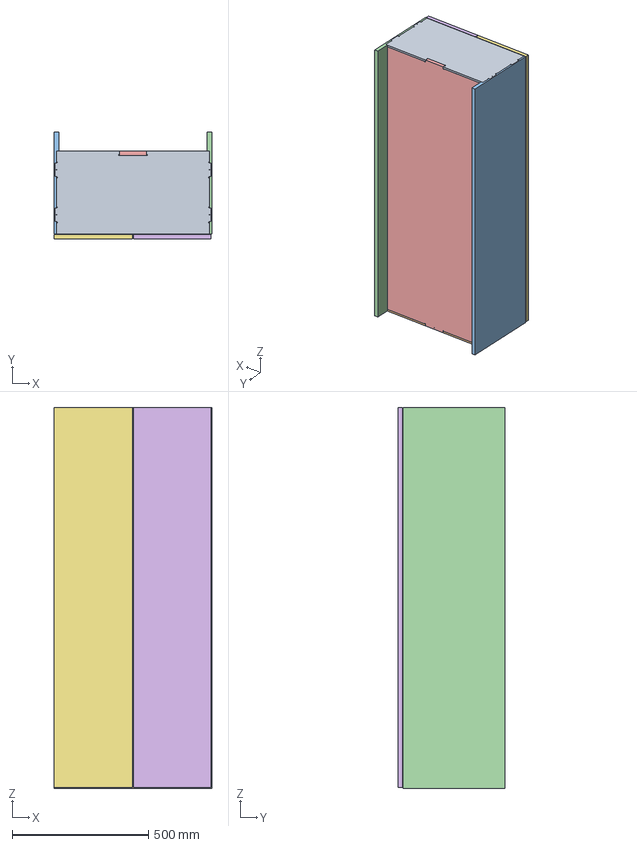
[picture p51: CAD file, 2022-04-19]
Assemblies/BasicCabinetWithTwoDoors.FCStd
580.0 x 395.0 x 1400.0 mm
Top
Bottom
Left
Right
BackPanel
RightDoor
LeftDoor
Shelf
