mavxg/kitchen/Assemblies/Hob.FCStd

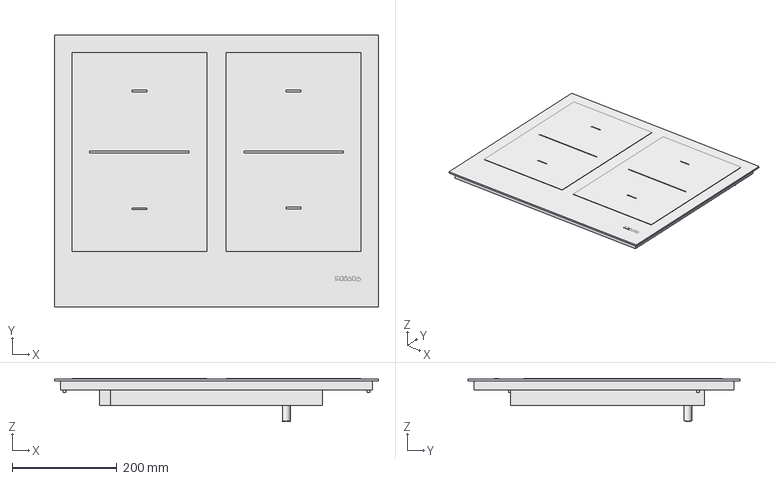
[picture p52: CAD file, 2022-04-19]
Assemblies/Hob.FCStd
620.0 x 520.0 x 82.5 mm
Building
11144050_GB_KM7564FL:26756470_GB_11144050_KM7564FL:204695
