mavxg/kitchen/Assemblies/BasicCabinet.FCStd

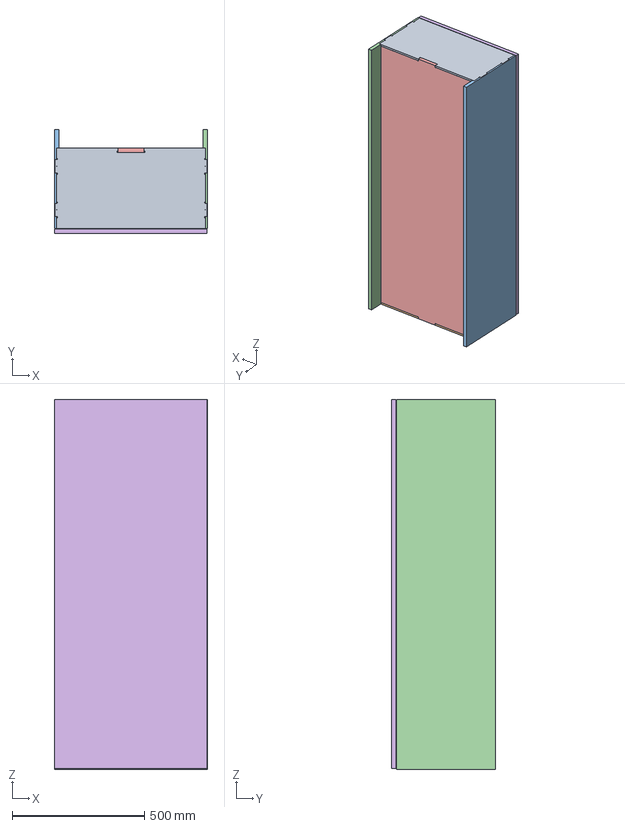
[picture p53: CAD file, 2022-04-19]
Assemblies/BasicCabinet.FCStd
580.0 x 395.0 x 1400.0 mm
Top
Bottom
Left
Right
BackPanel
Door
