mavxg/kitchen/Assemblies/Oven.FCStd

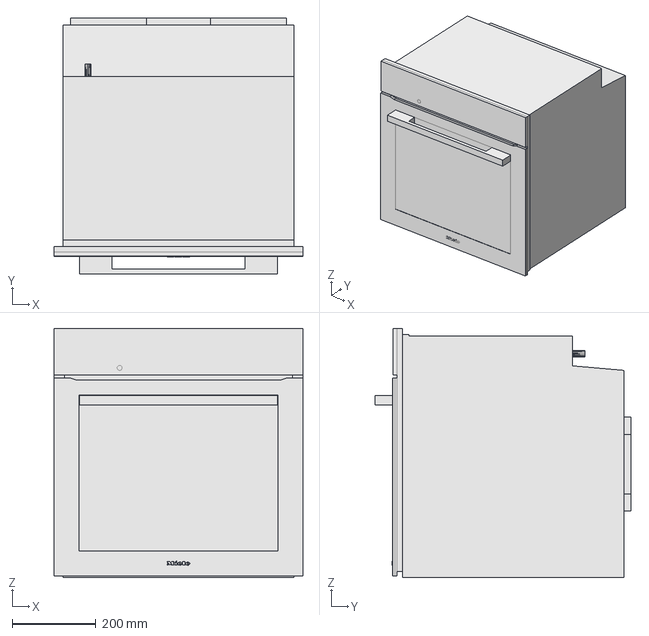
[picture p54: CAD file, 2022-04-19]
Assemblies/Oven.FCStd
595.0 x 611.0 x 596.0 mm
Building
11093450_GB_H7164BP_EDST-CLST:22716445_GB_11093450_H7164BP_EDST-CLST:206006
