mavxg/kitchen/(list of files, cad)

Other CAD files:
Assemblies/Cabinet010.FCStd
Assemblies/Hop.FCStd
Assemblies/BasicCabinetWithDoorRightHinge.FCStd
Assemblies/Dishwasher.FCStd
