mavxg/kitchen/(commit log)

2022-04-19 Initial Version@ @
    [BasicCabinet.FCStd, BasicCabinetWithDoorLeftHinge.FCStd, BasicCabinetWithDoorRightHinge.FCStd, BasicCabinetWithTwoDoors.FCStd, Cabinet001.FCStd, Cabinet002.FCStd, Cabinet003.FCStd, Cabinet004 3.FCStd]
2022-04-20 Updated Boiler Boxing
    [Cabinet007.FCStd, Cabinet011.FCStd, Cabinet013.FCStd, Cabinet014.FCStd, Cabinet015.FCStd, Cabinet016.FCStd, Kitchen.FCStd]
2022-04-23 Added cubby hole surround
    [Battons.FCStd, Cabinet001.FCStd, Cabinet002.FCStd, Cabinet003.FCStd, Cabinet004.FCStd, Cabinet005.FCStd, Cabinet006.FCStd, Cabinet007.FCStd]
2022-04-23 Added missing end panel
    [Cabinet004 3.FCStd, Cabinet006 3.FCStd, Cabinet007 3.FCStd, Cabinet008 3.FCStd, Cabinet008 4.FCStd, Cabinet009 3.FCStd, Cabinet010 3.FCStd, Cabinet012.FCStd]
2022-04-24 Added drawer boxes@
    [Battons.FCStd, Blum.FCStd, Cabinet001.FCStd, Cabinet002.FCStd, Cabinet003.FCStd, Cabinet004.FCStd, Cabinet005.FCStd, Cabinet006.FCStd]
2022-04-24 Panelise phase1 partial
    [Battons.FCStd, Cabinet001.FCStd, Cabinet002.FCStd, Cabinet003.FCStd, Cabinet004.FCStd, Cabinet005.FCStd, Cabinet006.FCStd, Cabinet007.FCStd]
2022-05-01 Added all drawer boxes
    [Battons.FCStd, BlancoOrga60_2.FCStd, Blum.FCStd, Cabinet001.FCStd, Cabinet002.FCStd, Cabinet003.FCStd, Cabinet004.FCStd, Cabinet005.FCStd]
2022-05-04 Phase 2 layout
    [Battons.FCStd, Cabinet001.FCStd, Cabinet007.FCStd, Cabinet011.FCStd, Cabinet012.FCStd, Cabinet014.FCStd, Cabinet015.FCStd, Cabinet016.FCStd]
2022-05-16 Adjusted all sides to account for 17.6mm top and bottom
    [Battons.FCStd, BlancoOrga60_2.FCStd, Cabinet001.FCStd, Cabinet002.FCStd, Cabinet003.FCStd, Cabinet004.FCStd, Cabinet005.FCStd, Cabinet006.FCStd]
